knielsen/pcb_f2_usb_hs/pcb-f2-a.kicad_pcb

## KiCad design pcb-f2-a.kicad_pcb (2018-07-21)

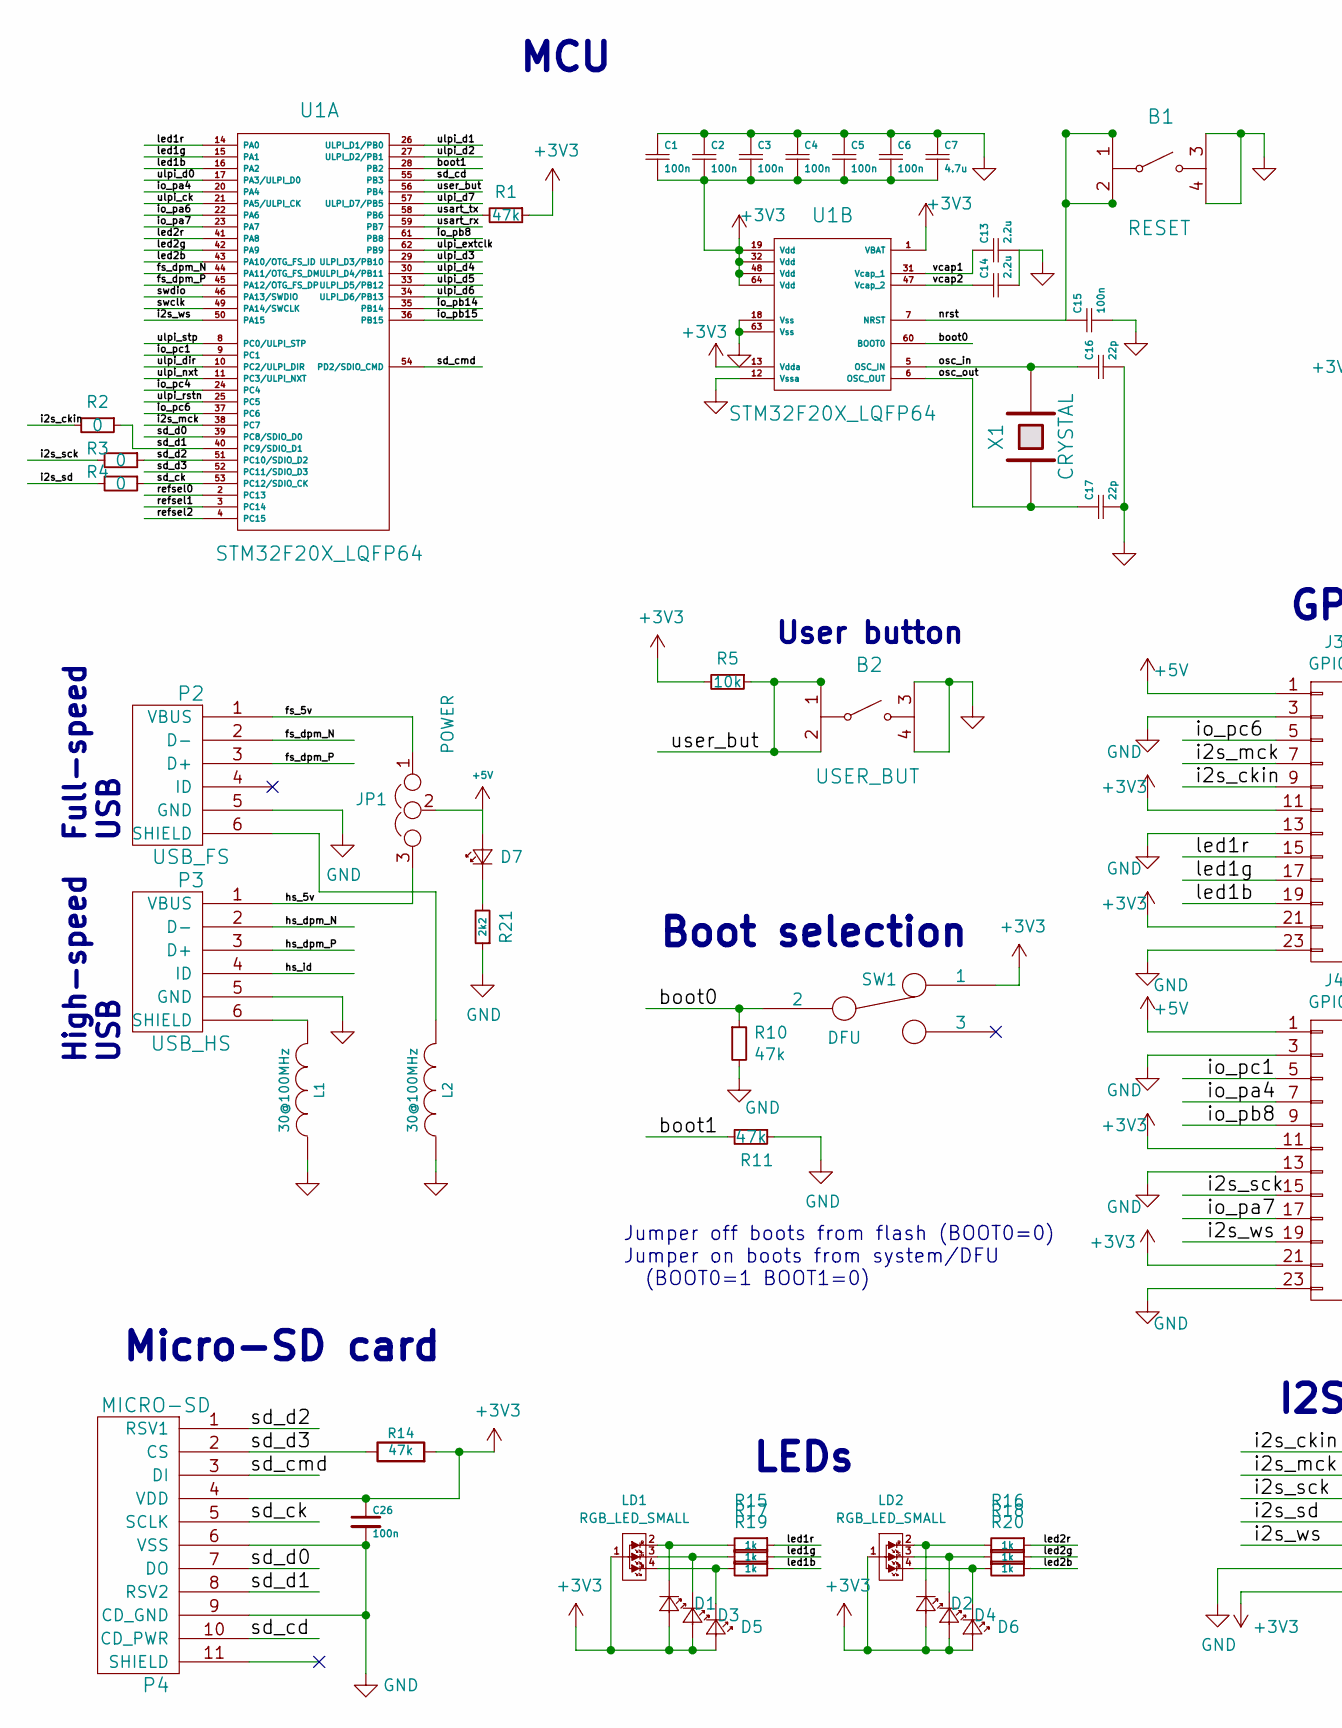
[picture p1: schematic pcb-f2-a.sch, part in row 1, column 1]

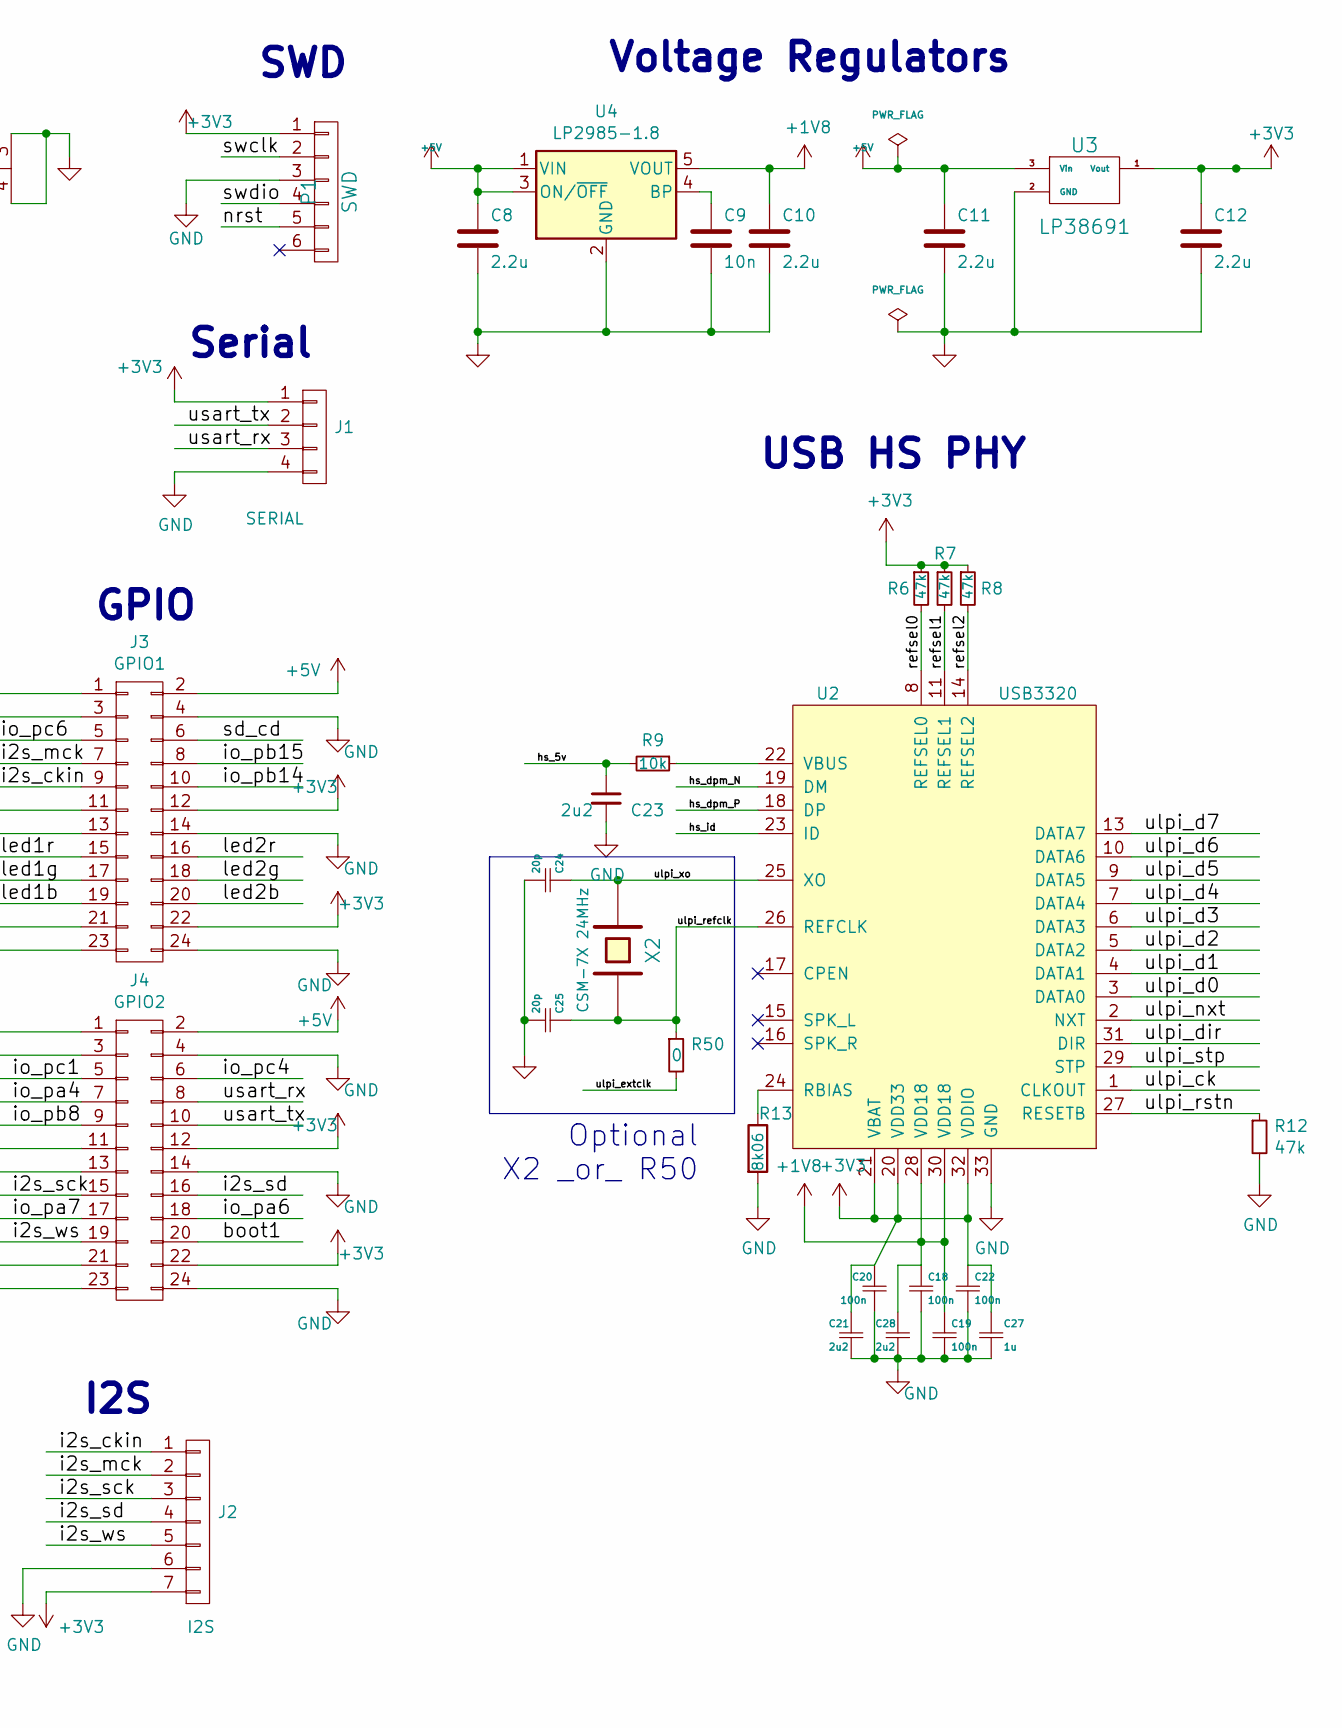
[picture p2: schematic pcb-f2-a.sch, part in row 1, column 2]

Parts:
B1: RESET; SWITCH_FSMJSMA
B2: USER_BUT; SWITCH_FSMJSMA
C1, C2, C3, C4, C5, C6, C15, C18, C19, C20, C22, C26: 100n; C_0603
C7: 4.7u; C_0805
C8, C10, C11, C12, C13, C14: 2.2u; C_0805
C9: 10n; C_0603
C16, C17: 22p; C_0603
C21, C23, C28: 2u2; C_0805
C24, C25: 20p; C_0603
C27: 1u; C_0805
D1, D2, D3, D4, D5, D6, D7: LED_Small; LED_0805_HandSoldering
J1: SERIAL; Pin_Header_Straight_1x04_Pitch2.54mm
J2: I2S; Pin_Header_Straight_1x07_Pitch2.54mm
J3: GPIO1; Socket_Strip_Straight_2x12_Pitch2.54mm
J4: GPIO2; Socket_Strip_Straight_2x12_Pitch2.54mm
JP1: POWER; Pin_Header_Straight_1x03_Pitch2.54mm
L1, L2: 30@100MHz; C_0603
LD1, LD2: RGB_LED_SMALL; RGB_0603
P1: SWD; Pin_Header_Straight_1x06_Pitch2.54mm
P2: USB_FS; 10103594-0001LF
P3: USB_HS; 10103594-0001LF
P4: MICRO-SD; SD_502774
R1, R6, R7, R8, R10, R11, R12, R14: 47k; R_0805
R2, R3, R4, R50: 0; R_0805
R5, R9: 10k; R_0805
R13: 8k06; R_0805
R15, R16, R17, R18, R19, R20: 1k; R_0805
R21: 2k2; R_0805
SW1: DFU; switch_msk_12c02
U1: STM32F20X_LQFP64; LQFP_64
U2: USB3320; QFN-32-USB-3320
U3: LP38691; TO-252-3
U4: LP2985-1.8; SOT-23-5
X1: CRYSTAL; 2-SOJ
X2: CSM-7X 24MHz; Crystal_SMD_HC49-US

Connections:
+1V8: C10.1, C18.1, C19.1, C28.1, U2.28 (VDD18), U2.30 (VDD18), U4.5 (VOUT)
+3V3: C1.2, C2.2, C3.2, C4.2, C5.2, C6.2, C7.2, C12.1, C20.1, C21.1, C22.1, C26.1, C27.1, D1.2 (A), D2.2 (A), D3.2 (A), D4.2 (A), D5.2 (A), D6.2 (A), J1.1, J2.7, J3.11, J3.12, J3.21, J3.22, J4.11, J4.12, J4.21, J4.22, LD1.1 (AG), LD2.1 (AG), P1.1, P4.4 (VDD), R1.1, R5.2, R6.1, R7.1, R8.1, R14.2, SW1.1, U1.1 (VBAT), U1.13 (Vdda), U1.19 (Vdd), U1.32 (Vdd), U1.48 (Vdd), U1.64 (Vdd), U2.20 (VDD33), U2.21 (VBAT), U2.32 (VDDIO), U3.1 (Vout)
+5V: C8.1, C11.1, D7.2 (A), J3.1, J3.2, J4.1, J4.2, JP1.2, U3.3 (Vin), U4.1 (VIN), U4.3 (ON/~OFF~)
/boot0: R10.1, SW1.2, U1.60 (BOOT0)
/boot1: J4.20, R11.2, U1.28 (PB2)
/fs_5v: JP1.1, P2.1 (VBUS)
/fs_dpm_N: P2.2 (D-), U1.44 (PA11/OTG_FS_DM)
/fs_dpm_P: P2.3 (D+), U1.45 (PA12/OTG_FS_DP)
/hs_5v: C23.1, JP1.3, P3.1 (VBUS), R9.2
/hs_dpm_N: P3.2 (D-), U2.19 (DM)
/hs_dpm_P: P3.3 (D+), U2.18 (DP)
/hs_id: P3.4 (ID), U2.23 (ID)
/i2s_ckin: J2.1, J3.9, R2.2
/i2s_mck: J2.2, J3.7, U1.38 (PC7)
/i2s_sck: J2.3, J4.15, R3.2
/i2s_sd: J2.4, J4.16, R4.2
/i2s_ws: J2.5, J4.19, U1.50 (PA15)
/io_pa4: J4.7, U1.20 (PA4)
/io_pa6: J4.18, U1.22 (PA6)
/io_pa7: J4.17, U1.23 (PA7)
/io_pb8: J4.9, U1.61 (PB8)
/io_pb14: J3.10, U1.35 (PB14)
/io_pb15: J3.8, U1.36 (PB15)
/io_pc1: J4.5, U1.9 (PC1)
/io_pc4: J4.6, U1.24 (PC4)
/io_pc6: J3.5, U1.37 (PC6)
/led1b: J3.19, R19.1, U1.16 (PA2)
/led1g: J3.17, R17.1, U1.15 (PA1)
/led1r: J3.15, R15.1, U1.14 (PA0)
/led2b: J3.20, R20.1, U1.43 (PA10/OTG_FS_ID)
/led2g: J3.18, R18.1, U1.42 (PA9)
/led2r: J3.16, R16.1, U1.41 (PA8)
/nrst: B1.1, B1.2, C15.1, P1.5, U1.7 (NRST)
/osc_in: C16.1, U1.5 (OSC_IN), X1.2
/osc_out: C17.1, U1.6 (OSC_OUT), X1.1
/refsel0: R6.2, U1.2 (PC13), U2.8 (REFSEL0)
/refsel1: R7.2, U1.3 (PC14), U2.11 (REFSEL1)
/refsel2: R8.2, U1.4 (PC15), U2.14 (REFSEL2)
/sd_cd: J3.6, P4.10 (CD_PWR), U1.55 (PB3)
/sd_ck: P4.5 (SCLK), R4.1, U1.53 (PC12/SDIO_CK)
/sd_cmd: P4.3 (DI), U1.54 (PD2/SDIO_CMD)
/sd_d0: P4.7 (DO), U1.39 (PC8/SDIO_D0)
/sd_d1: P4.8 (RSV2), R2.1, U1.40 (PC9/SDIO_D1)
/sd_d2: P4.1 (RSV1), R3.1, U1.51 (PC10/SDIO_D2)
/sd_d3: P4.2 (CS), R14.1, U1.52 (PC11/SDIO_D3)
/swclk: P1.2, U1.49 (PA14/SWCLK)
/swdio: P1.4, U1.46 (PA13/SWDIO)
/ulpi_ck: U1.21 (PA5/ULPI_CK), U2.1 (CLKOUT)
/ulpi_d0: U1.17 (PA3/ULPI_D0), U2.3 (DATA0)
/ulpi_d1: U1.26 (ULPI_D1/PB0), U2.4 (DATA1)
/ulpi_d2: U1.27 (ULPI_D2/PB1), U2.5 (DATA2)
/ulpi_d3: U1.29 (ULPI_D3/PB10), U2.6 (DATA3)
/ulpi_d4: U1.30 (ULPI_D4/PB11), U2.7 (DATA4)
/ulpi_d5: U1.33 (ULPI_D5/PB12), U2.9 (DATA5)
/ulpi_d6: U1.34 (ULPI_D6/PB13), U2.10 (DATA6)
/ulpi_d7: U1.57 (ULPI_D7/PB5), U2.13 (DATA7)
/ulpi_dir: U1.10 (PC2/ULPI_DIR), U2.31 (DIR)
/ulpi_extclk: R50.2, U1.62 (PB9)
/ulpi_nxt: U1.11 (PC3/ULPI_NXT), U2.2 (NXT)
/ulpi_refclk: C25.1, R50.1, U2.26 (REFCLK), X2.1
/ulpi_rstn: R12.1, U1.25 (PC5), U2.27 (RESETB)
/ulpi_stp: U1.8 (PC0/ULPI_STP), U2.29 (STP)
/ulpi_xo: C24.1, U2.25 (XO), X2.2
/usart_rx: J1.3, J4.8, U1.59 (PB7)
/usart_tx: J1.2, J4.10, R1.2, U1.58 (PB6)
/user_but: B2.1, B2.2, R5.1, U1.56 (PB4)
/vcap1: C13.1, U1.31 (Vcap_1)
/vcap2: C14.1, U1.47 (Vcap_2)
GND: B1.3, B1.4, B2.3, B2.4, C1.1, C2.1, C3.1, C4.1, C5.1, C6.1, C7.1, C8.2, C9.2, C10.2, C11.2, C12.2, C13.2, C14.2, C15.2, C16.2, C17.2, C18.2, C19.2, C20.2, C21.2, C22.2, C23.2, C24.2, C25.2, C26.2, C27.2, C28.2, J1.4, J2.6, J3.3, J3.4, J3.13, J3.14, J3.23, J3.24, J4.3, J4.4, J4.13, J4.14, J4.23, J4.24, L1.1, L2.1, P1.3, P2.5 (GND), P3.5 (GND), P4.6 (VSS), P4.9 (CD_GND), R10.2, R11.1, R12.2, R13.2, R21.1, U1.12 (Vssa), U1.18 (Vss), U1.63 (Vss), U2.33 (GND), U3.2 (GND), U4.2 (GND)
unnamed: C9.1, U4.4 (BP)
unnamed: D1.1 (K), LD1.2 (R), R15.2
unnamed: D2.1 (K), LD2.2 (R), R16.2
unnamed: D3.1 (K), LD1.3 (R), R17.2
unnamed: D4.1 (K), LD2.3 (R), R18.2
unnamed: D5.1 (K), LD1.4 (R), R19.2
unnamed: D6.1 (K), LD2.4 (R), R20.2
unnamed: D7.1 (K), R21.2
unnamed: L1.2, P3.6 (SHIELD)
unnamed: L2.2, P2.6 (SHIELD)
unnamed: R9.1, U2.22 (VBUS)
unnamed: R13.1, U2.24 (RBIAS)

Notes on the sheet:
Boot selection
Jumper off boots from flash (BOOT0=0) Jumper on boots from system/DFU (BOOT0=1 BOOT1=0)
MCU
Voltage Regulators
Micro-SD card
SWD
Optional X2 _or_ R50
User button
Full-speed USB
High-speed USB
Serial
LEDs
I2S
USB HS PHY
GPIO

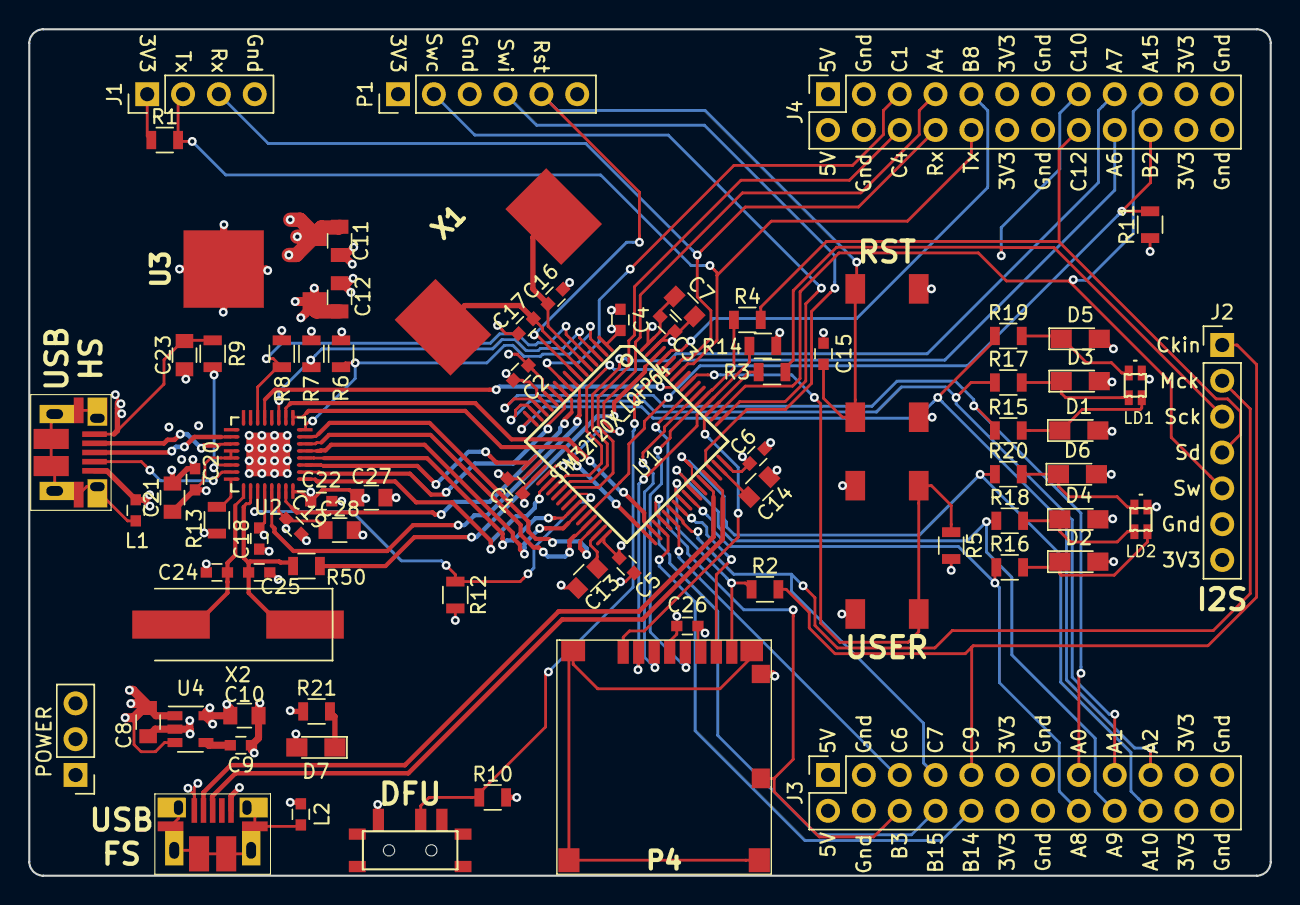
[picture p3: board pcb-f2-a.kicad_pcb from above]

Board: 4 copper layers, 88.0 x 60.0 mm, 79 parts (0 on the bottom side), 81 nets.
