knielsen/pcb_f2_usb_hs/(commit log)

2018-06-14 Rev1, sent for manufacture
    [pcb-f2-a-B.Cu.gbl, pcb-f2-a-B.Mask.gbs, pcb-f2-a-B.SilkS.gbo, pcb-f2-a-Edge.Cuts.gm1, pcb-f2-a-F.Cu.gtl, pcb-f2-a-F.Mask.gts, pcb-f2-a-F.Paste.gtp, pcb-f2-a-F.SilkS.gto]
2018-07-21 Fix missing back-copper on USB thrugh-hole pads
    [pcb-f2-a.kicad_pcb]
